carlinhosrb/projetos/SMME/fotos/WhatsApp Image 2021-09-27 at 10.28.32.jpeg

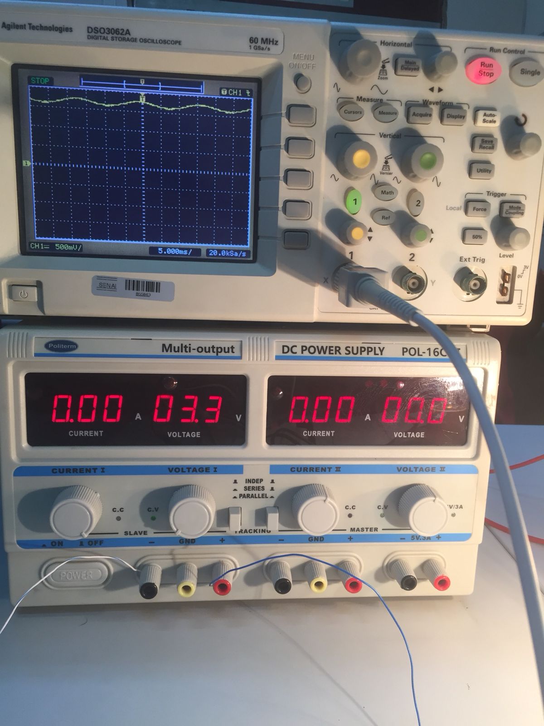
SMME/fotos/WhatsApp Image 2021-09-27 at 10.28.32.jpeg
