carlinhosrb/projetos/SMME/pci/pci.pdf

# CONFECÇÃO DA PCI

# VISUALIZAÇÃO EM 3D

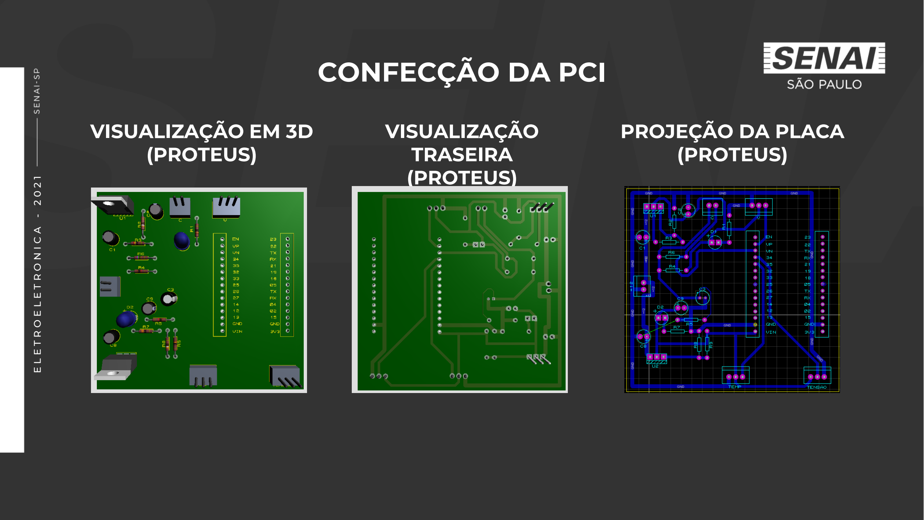
[picture p49: page 1]

E L E T R O E L E T R O N I C A - 2 0 2 1

# (PROTEUS)

# VISUALIZAÇÃO TRASEIRA (PROTEUS)

# PROJEÇÃO DA PLACA (PROTEUS)

# PLACA UNIVERSAL

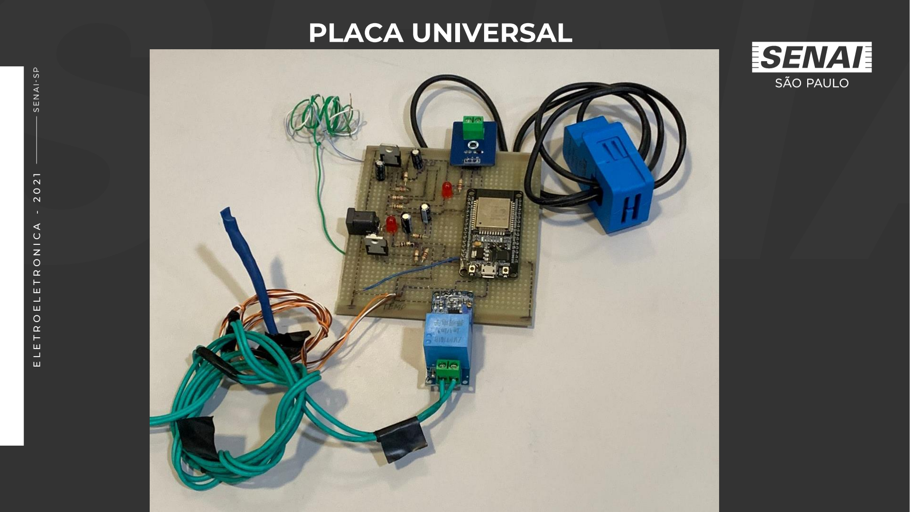
[picture p50: page 2]

E L E T R O E L E T R O N I C A - 2 0 2 1
