carlinhosrb/projetos/SMME/fotos/6D6A61AE-8B32-42AE-BF0B-8947AB7DC76F (1).jpeg

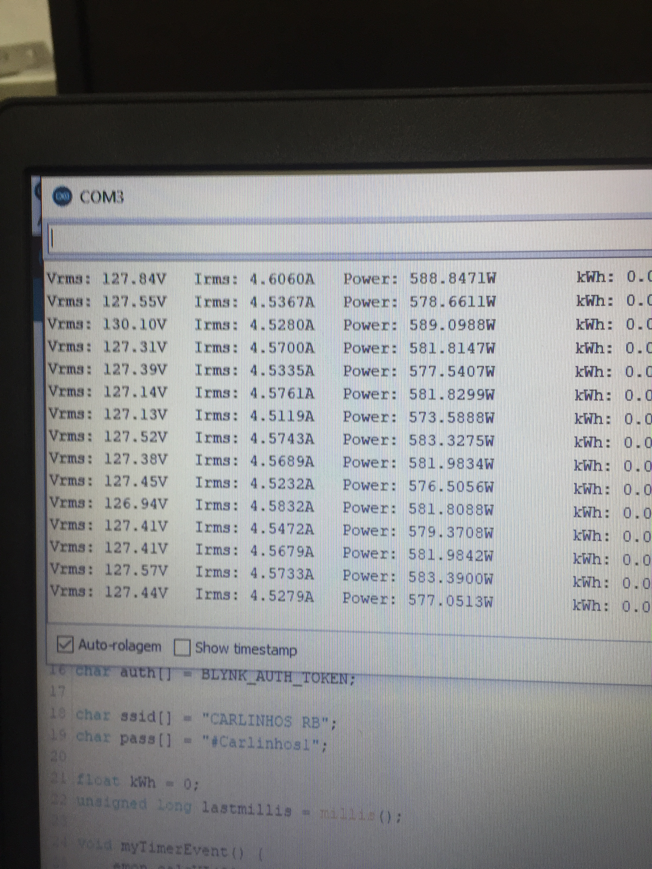
SMME/fotos/6D6A61AE-8B32-42AE-BF0B-8947AB7DC76F (1).jpeg
