carlinhosrb/projetos/SMME/fotos/PHOTO-2021-09-19-15-31-38 (1).jpg

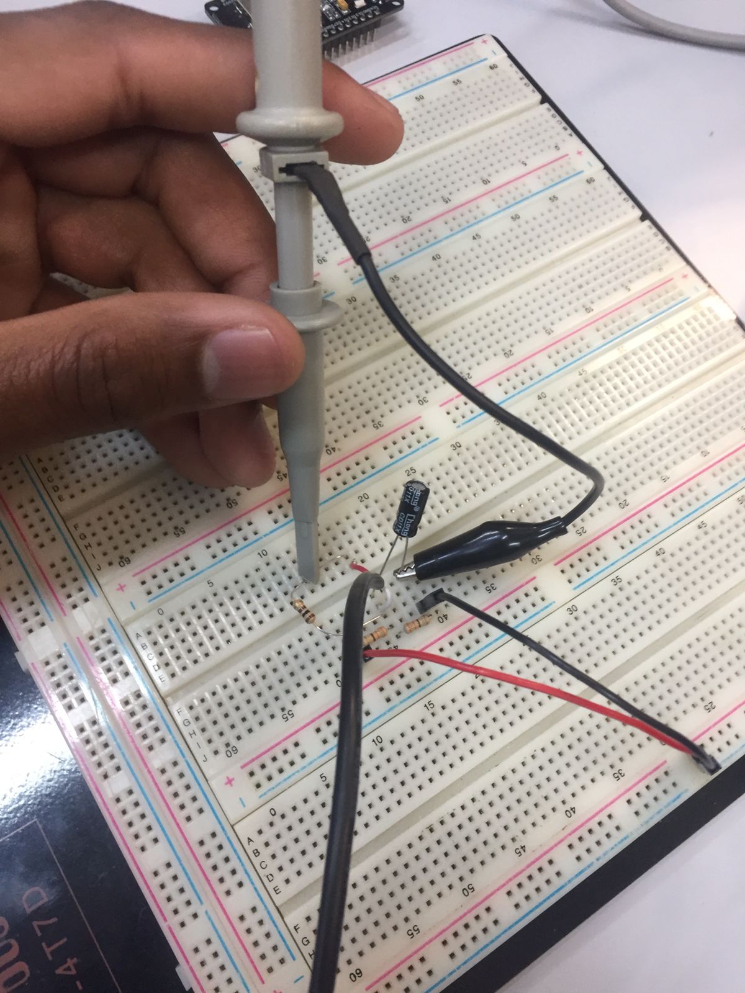
SMME/fotos/PHOTO-2021-09-19-15-31-38 (1).jpg
