carlinhosrb/projetos/SMME/HARDWARE COMPLETO/Circ fn.png

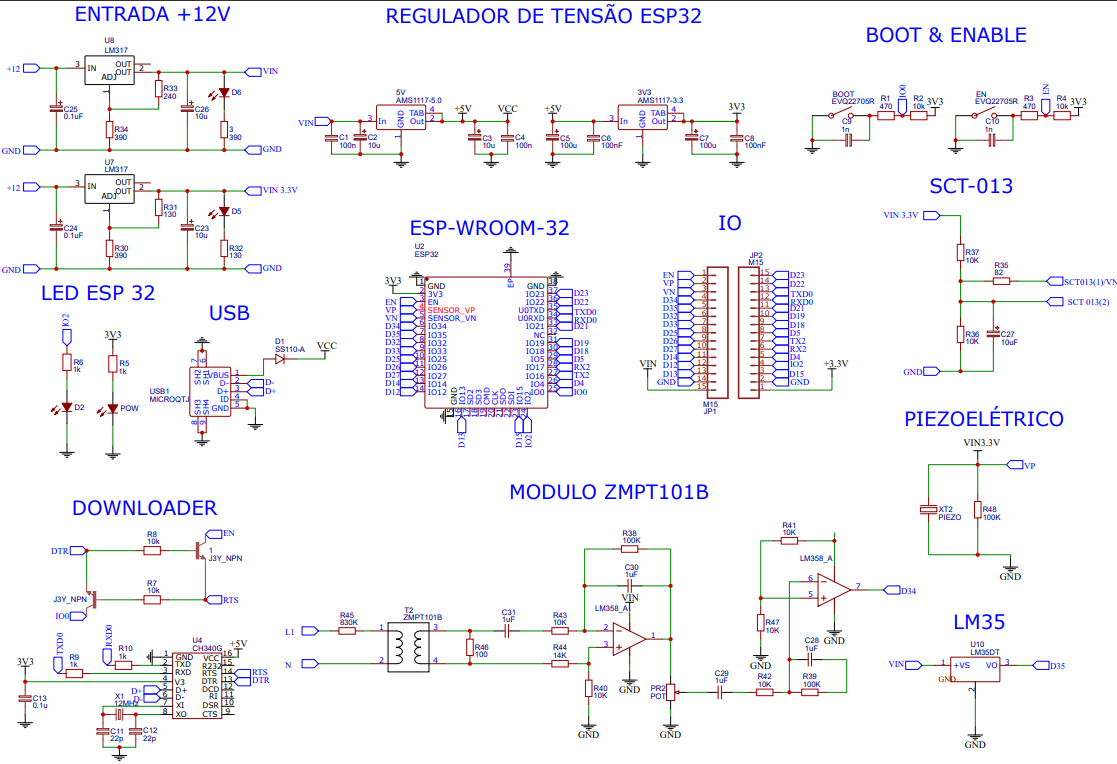
SMME/HARDWARE COMPLETO/Circ fn.png
