carlinhosrb/projetos/(list of files, cad)

Other CAD files:
SMME/SketchUp/salvo.skp
